matthewSorensen/Jubilee-Modifications/hemera-tool/ModifiedHemeraPlate.stp

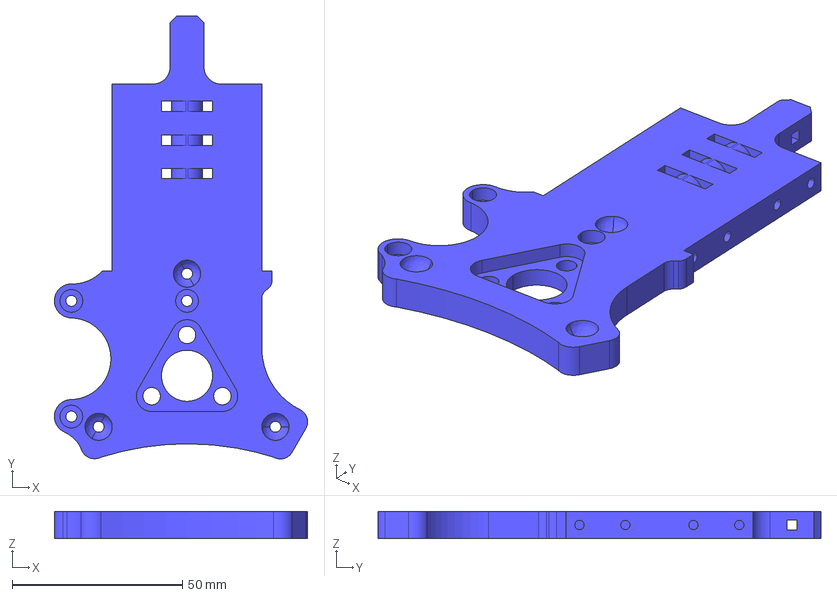
[picture p1: CAD file, 2021-01-24]
hemera-tool/ModifiedHemeraPlate.stp
74.4 x 130.2 x 8.00 mm
