matthewSorensen/Jubilee-Modifications/toolposts/MultifixPost.stl

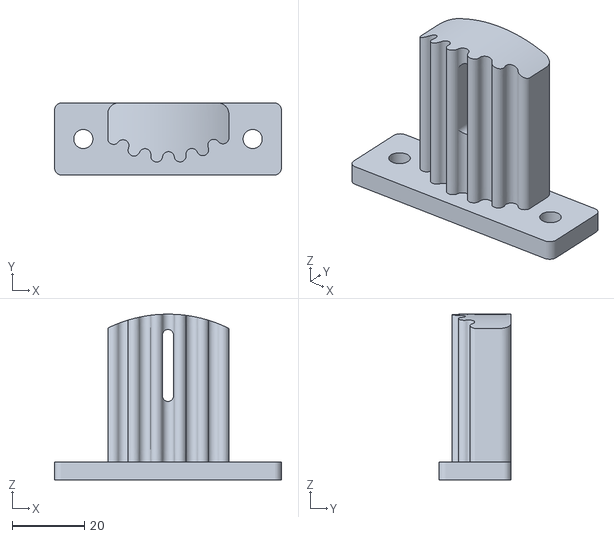
[picture p2: CAD file, 2021-01-24]
toolposts/MultifixPost.stl
63.0 x 20.0 x 46.0
