matthewSorensen/Jubilee-Modifications/toolwings/DoubleFlexure.stp

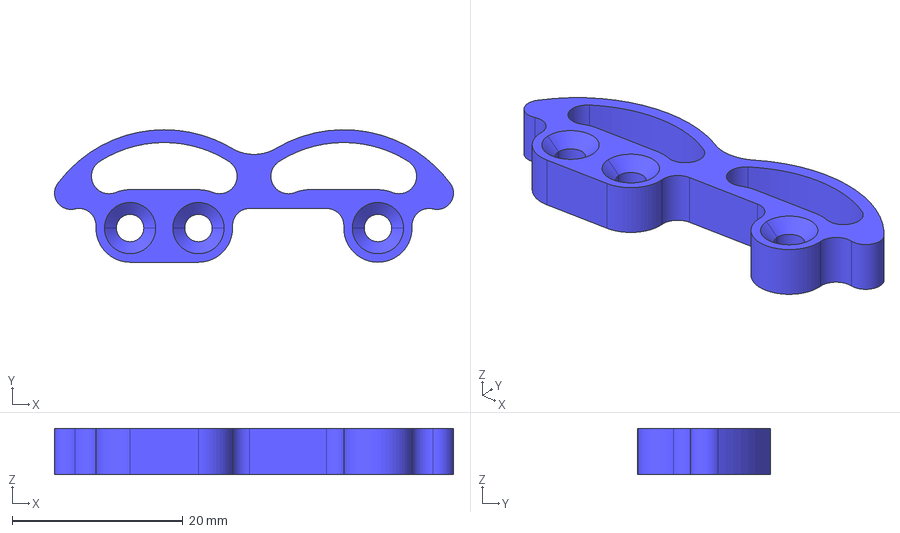
[picture p3: CAD file, 2020-09-06]
toolwings/DoubleFlexure.stp
46.7 x 15.5 x 5.40 mm
