matthewSorensen/Jubilee-Modifications/hemera-tool/HemeraSpacer.dxf

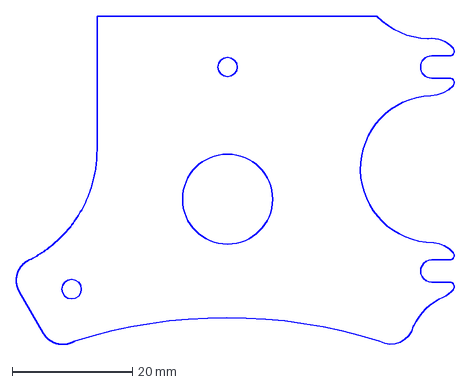
[picture p4: CAD file, 2021-01-24]
hemera-tool/HemeraSpacer.dxf
73.0 x 54.8 mm
