matthewSorensen/Jubilee-Modifications/toolposts/MultifixHorn.stl

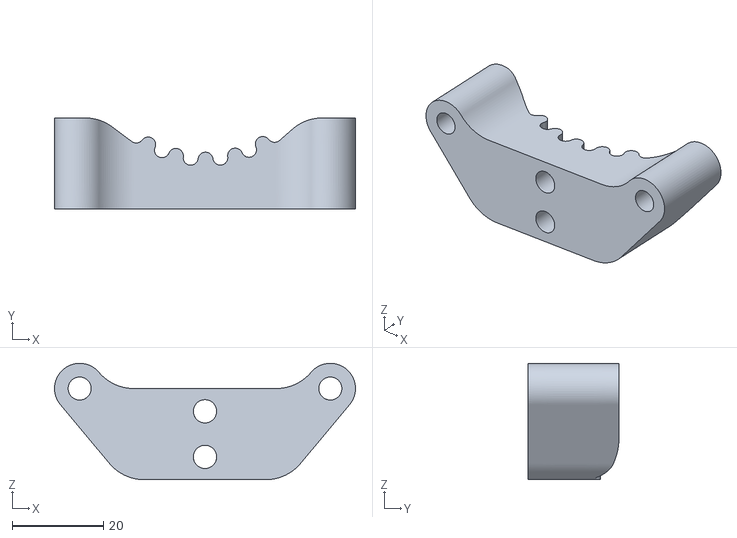
[picture p5: CAD file, 2021-01-24]
toolposts/MultifixHorn.stl
66.0 x 20.0 x 25.5
