matthewSorensen/Jubilee-Modifications/toolwings/ExtraLongWing.stp

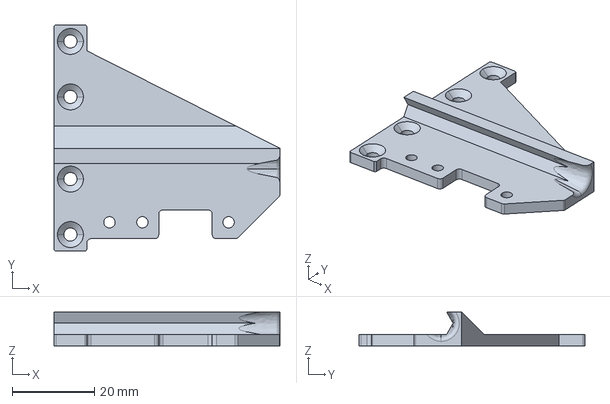
[picture p6: CAD file, 2020-09-06]
toolwings/ExtraLongWing.stp
55.0 x 55.0 x 8.20 mm
