matthewSorensen/Jubilee-Modifications/toolposts/MultifixSpacer.stl

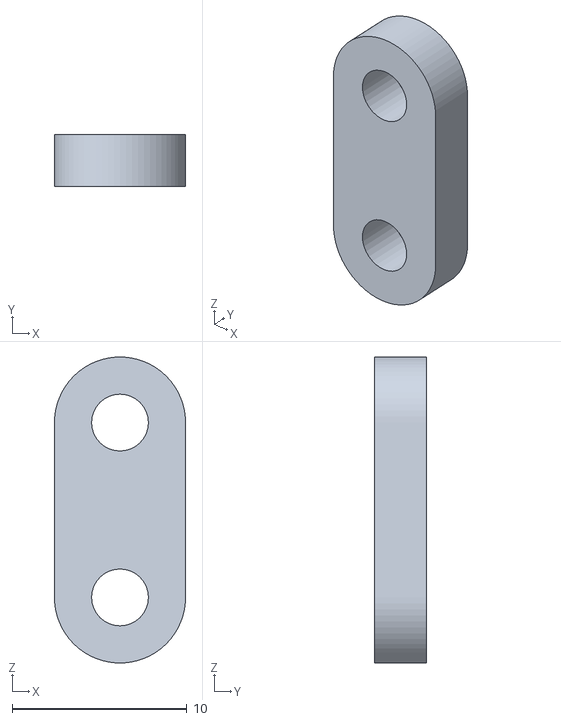
[picture p7: CAD file, 2021-01-24]
toolposts/MultifixSpacer.stl
7.50 x 3.00 x 17.5
