matthewSorensen/Jubilee-Modifications/toolwings/LargeWing.stp

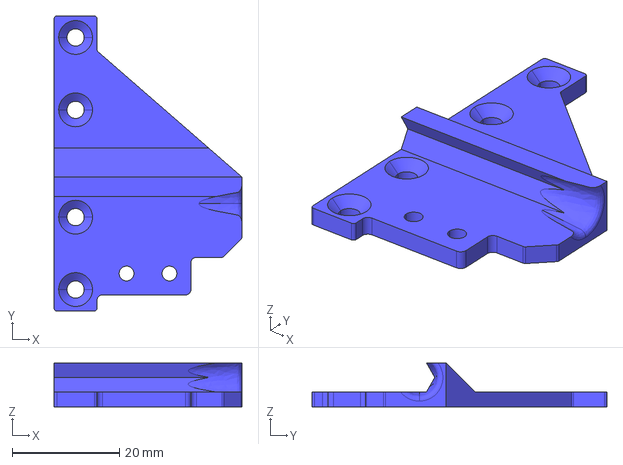
[picture p8: CAD file, 2020-08-06]
toolwings/LargeWing.stp
35.0 x 55.0 x 8.20 mm
