matthewSorensen/Jubilee-Modifications/toolwings/SmallWing.stp

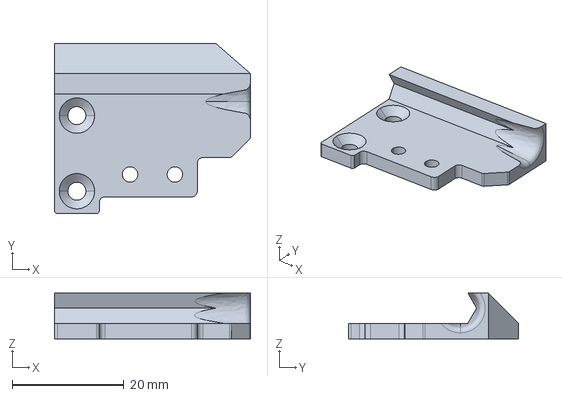
[picture p9: CAD file, 2020-08-06]
toolwings/SmallWing.stp
35.0 x 30.4 x 8.20 mm
