matthewSorensen/Jubilee-Modifications/toolwings/Flexure.stp

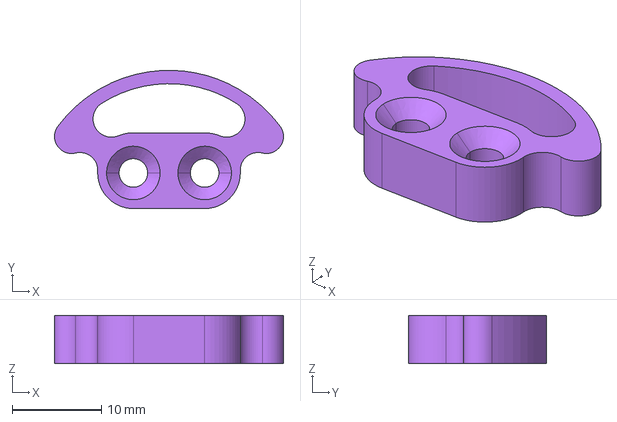
[picture p10: CAD file, 2020-07-23]
toolwings/Flexure.stp
25.7 x 15.5 x 5.40 mm
