matthewSorensen/Jubilee-Modifications/(list of files, cad)

Other CAD files:
ModifiedWings.3dm
hemera-tool/ModifiedHemeraPlate.stl
toolwings/DoubleFlexure.stl
toolwings/ExtraLongWing.stl
toolwings/Flexure.stl
toolwings/LargeWing.stl
toolwings/SmallWing.stl
