matthewSorensen/Jubilee-Modifications/(commit log)

2020-07-23 New geometry
    [Flexure.stl, Flexure.stp, LargeWing.stl, LargeWing.stp, ModifiedWings.3dm, SmallWing.stl, SmallWing.stp]
2020-08-06 Update wing for clearance with hemera idler
    [LargeWing.stl, LargeWing.stp, SmallWing.stl, SmallWing.stp]
2020-09-06 Giant (shall we say chonky?) versions of everything for holding hemeras with great vigor
    [DoubleFlexure.stl, DoubleFlexure.stp, ExtraLongWing.stl, ExtraLongWing.stp]
2021-01-24 Mod to hemera tool plate to fix warp issues
    [HemeraSpacer.dxf, ModifiedHemeraPlate.stl, ModifiedHemeraPlate.stp]
2021-01-24 Move all the tool wing stuff into it's own subdir
    [DoubleFlexure.stl, DoubleFlexure.stp, ExtraLongWing.stl, ExtraLongWing.stp, Flexure.stl, Flexure.stp, LargeWing.stl, LargeWing.stp]
2021-01-24 Full reorg
    [MultifixHorn.stl, MultifixPost.stl, MultifixSpacer.stl]
